Aneeshparveda/NEXUS-32/docs/STATUS.md

# NEXUS-32 Status

**Last updated: 2026-11-13.**

## Board evidence (2026-11-13)

The full SoC ran on a Digilent Basys 3. The record is in
[`results/board_2026-11-13/MANIFEST.md`](../results/board_2026-11-13/MANIFEST.md).

- **Build:** LANES=8, 50 MHz (MMCM), Vivado 2024.2, part `xc7a35tcpg236-1`,
  from commit `e17d20b` (RTL identical to `2f87f96`). Bitstream SHA-256
  `47778f086f2dbdc5f28398d9971b84cd960760fddf56c5cefc4eb3de6ce6f43d`.
- **Routed timing met at 50 MHz:** WNS +0.468 ns, WHS +0.014 ns, 0 failing
  endpoints.
- **Critical path:** in the sequential engine, `tap_count_q_reg` to
  `result_o_reg`, 19.453 ns over 30 logic levels.
- **Implemented utilization:** 4695 LUT, 3614 FF, 68/90 DSP48E1
  (PAR 32, PIPE 32, SEQ 4), 13/50 BRAM tiles. DRC 0 errors; Methodology
  0 critical.
- **On the board:**
  - LD0 and LD2 on, LD3 off.
  - The UART printed `NEXUS32 RESULT: PASS` with SEQ / PAR / PIPE
    `cycles_total` 14352 / 5136 / 9232, identical to simulation.
  - 82 reports, all PASS, 0 FAIL. 61 are complete; the other 21 were
    truncated by the terminal window.
- **Die temperature:** 33.3 °C, measured with System Monitor (XADC).
- **Power:** 0.194 W, a vectorless Vivado estimate dominated by the MMCM
  (87% of dynamic power).
- **Software baseline (RTL simulation):** the same FIR in plain C on the
  PicoRV32 alone (no multiplier) takes 13,289,345 cycles at 8 taps. The
  accelerator is 926x (SEQ) to 2,587x (PAR) faster at 8 taps, and up to
  15,818x faster at 32 taps. See
  [`experiments/sw_baseline/README.md`](../experiments/sw_baseline/README.md).

This file is the single detailed status record the README status banner
points to. The CI badge at the top of the README is the live CI signal;
the runs listed below are point-in-time checks.

## Current HEAD

- Last reviewed against main at `07551d8` ("Merge pull request #10",
  pre-Vivado audit fixes). This update adds the first board evidence.

## CI status

- CI run #17 on `b24474b`: completed, conclusion **success**
  (verified 2026-11-10 from the GitHub Actions API):
  https://github.com/Aneeshparveda/NEXUS-32/actions/runs/42710687047
- CI run #12 on `c74f5e1`: completed, conclusion **success**
  (verified 2026-10-26 from the GitHub Actions API):
  https://github.com/Aneeshparveda/NEXUS-32/actions/runs/40233635198
- CI run #10 on `21d2db4`: completed, conclusion **success**
  (verified 2026-10-26 from the GitHub Actions API):
  https://github.com/Aneeshparveda/NEXUS-32/actions/runs/40227687445
- Earlier CI run #8 on `dabb71b` was the last verified run recorded in
  the previous README banner; it is superseded as the latest check by
  runs #10 and #12 above.
- CI on any commit pushed after this STATUS update is not yet verified
  and must be checked the same way before it is claimed.
- Passing CI is simulation and toolchain evidence only. It does not
  perform Vivado synthesis, timing closure, bitstream generation, board
  programming, or physical validation.

## What is claimed

- Simulation + CI verification of the PicoRV32 SoC with Sequential,
  Parallel, and Pipelined FIR accelerators under the frozen Q16.16
  contract in `docs/ACCELERATOR_CONTRACT_V1.md`.
- Functional block-processing cycle counts and verification closure as
  recorded in `docs/VERIFICATION_CLOSURE.md` and summarised in the README
  Results section (simulation only; see the caveat attached to that
  table — the integrated shell serializes to one outstanding operation,
  so those counts are not standalone architecture throughput or PPA).
- SoC START-to-verdict latency of 129 cycles at LANES=32 is a simulation
  figure only, not a board measurement and not `CYCLES_TOTAL`.
- Board demo firmware, simulation only: through PicoRV32, a 1024-sample block
  with `TAP_COUNT = LANES` matches the Python-golden checksum on all three
  engines at LANES 4/8/16/32, and the UART report is decoded independently by
  `tests/rtl/tb_nexus32_soc_demo.sv` (`scripts/run_soc_demo.sh all`).

## What is NOT claimed

- Timing closure at 100 MHz is not claimed. 100 MHz builds miss timing
  (routed WNS -7.980 ns at LANES=4 and -8.935 ns at LANES=8, from the
  scripted Vivado 2024.2 run). Only the 50 MHz board build is
  timing-clean.
- Only the LANES=8 board build is hardware-verified. LANES=4 at 50 MHz
  also met timing in Vivado (WNS +0.417 ns) but was not run on the board.
  LANES=16/32 are not claimed for the board: the core sweep shows the
  selector needs more than the 90 DSP48E1 slices.
- The 25 MHz MMCM option has not been built.
- Power and junction temperature are Vivado estimates. Board current was
  not measured.
- No demo video exists yet.
- The board wrapper default (LANES=8 in `rtl/top_basys3.sv`) and the
  integrated shell default (LANES=32) are source defaults, not fit or
  timing results.

## Known limitations

- Vivado findings on the 50 MHz board build (advisory; RTL frozen for the
  board run; see `results/board_2026-11-13/MANIFEST.md`):
  - DSP48E1 inputs and outputs are not registered (DPIP-1, DPOP-1), which
    gives the 30-level sequential-engine path.
  - BRAM control pins are driven by a register with an asynchronous reset
    (REQP-1839).
  - A LUT drives the reset synchronizer's asynchronous preset (LUTAR-1).
  - The unused 7-segment display lights because its pins are not driven.
- `ARCH_SEL=11` is rejected; no adaptive/Auto policy is implemented.
  (`docs/ACCELERATOR_CONTRACT_V1.md`; `rtl/fir_arch_selector.sv`)
- The CPU integration is single-master and does not yet implement DMA,
  UART receive, GPIO, interrupts, Sample B, STREAM-DB, or the planned system
  debug monitor. The system page provides UART transmit and SYS_INFO only.
  (`rtl/fir_seq_accel.sv`, `rtl/nexus32_soc.sv`)
- PicoRV32 native memory has no dedicated error response input; the
  wrapper exposes sticky bus-fault status and passes the accelerator's
  diagnostic response data (for example the protected-memory sentinel
  `0xBAD0_0001`) through to the CPU on an errored MMIO response.
  (`rtl/nexus32_accel_bus.sv`; `rtl/nexus32_soc.sv`; `make test-fault`;
  assumed: the pinned `picorv32.v` was not checked)
- `LANES` also caps the filter length: `TAP_COUNT` must be 1..`LANES`, so a
  LANES=4 build runs at most a 4-tap filter. A larger `TAP_COUNT` is
  rejected at START as an invalid configuration.
  (`rtl/fir_seq_accel.sv` `config_valid`; `rtl/fir_arch_selector.sv`
  `invalid_request`)
- The block controller waits for each BRAM read response with no timeout
  (`EXEC_COEFF_WAIT`, `EXEC_SAMPLE_WAIT` in `rtl/fir_seq_accel.sv`). This
  relies on `rtl/fir_tap_bram.sv` answering every accepted read one cycle
  later. A lost response would leave `BUSY` set until `CTRL.RESET`; no test
  injects one, and the shipped BRAM cannot produce one.
- The parallel engine reports an invalid tap count as an `error_o` pulse
  with no `out_valid_o`, as its header and `docs/PARALLEL_ENGINE.md`
  state. Through `rtl/fir_arch_selector.sv` this is unreachable, because
  the selector answers invalid requests itself; a standalone user must
  watch `error_o`.
