Aneeshparveda/NEXUS-32/results/board_2026-11-13/screenshots.pdf

Evidence index (snapshot 2026-11-13, about 4:20 PM, final compile) | NEXUS-32 | LANES=8, 50 MHz | Vivado 2024.2 | page 1
# | Screenshot | State

1 | Sources hierarchy | In this PDF
2 | Top-level RTL schematic | In this PDF
3 | RTL schematic inside u_soc | In this PDF
4 | Synthesized utilization | In this PDF
5 | Routed timing summary | In this PDF
6 | Critical path | In this PDF
7 | Implemented utilization, Summary | In this PDF
8 | Implemented utilization, Hierarchy | In this PDF
DRC | DRC report (0 errors) | In this PDF
Meth | Methodology report (0 critical) | In this PDF
9 | Power estimate | In this PDF
9b | Power supply breakdown (Vccint 0.026 A) | In this PDF
10 | Device view, per-engine colours | In this PDF
10b | Colour legend | In this PDF
BS | Bitstream generated (Design Runs) | In this PDF
HW | Hardware Manager: board connected | In this PDF
11 | System Monitor temperature, 33.3 C (measured) | In this PDF
12 | UART report, NEXUS32 RESULT: PASS | In this PDF
S2 | Simulation waveform | In this PDF
Board | LED photo and board photos | In this PDF
S1 | Simulation console (3 x check=PASS) | Not captured; optional, covered by board UART log (82 x PASS)

Headline results (LANES=8, 50 MHz, xc7a35tcpg236-1)
Simulation PASS (cycles SEQ 14352 / PAR 5136 / PIPE 9232, checksum 0xb2be7f16). Synthesis, implementation and bitstream complete. Routed timing met: WNS +0.468 ns, WHS +0.014 ns, 0 failing endpoints. Implemented: 4695 LUT / 3614 FF / 68 DSP / 13 BRAM. Power estimate 0.194 W (MMCM 87% of dynamic); 163 DRC and 82 methodology warnings, no errors or critical items. On the Basys 3: LD0 and LD2 on, LD3 off, UART report NEXUS32 RESULT: PASS with cycles 14352 / 5136 / 9232 (identical to simulation), measured die temperature 33.3 C. Vivado power and junction temperature are estimates; the System Monitor reading is a measurement.

Screenshot 1: Sources hierarchy | NEXUS-32 | LANES=8, 50 MHz | Vivado 2024.2 | page 2

Hierarchy view: top_basys3 > u_soc (nexus32_soc) > u_uart_tx, u_cpu (picorv32), u_accel_bus > u_accel (fir_seq_accel) > u_tap_bram, u_arch_selector > u_seq_engine, u_parallel_engine, u_pipelined_engine. The xil_defaultlib.*_MUST_BE_* entries are parameter-guard modules for LANES and SYS_CLK_MHZ (valid at LANES=8, 50 MHz). Cropped from the Vivado window.

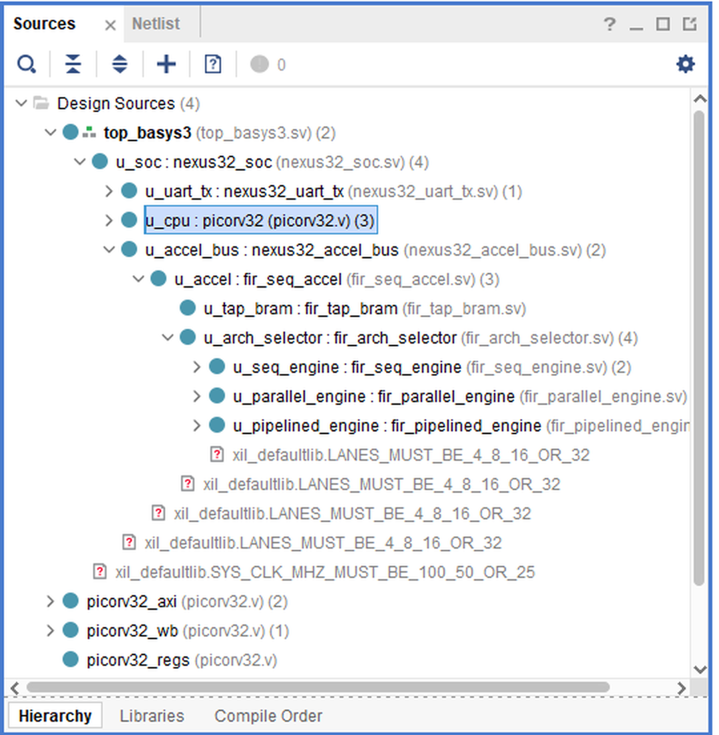
[picture p1: figure]

Screenshot 2: Top-level RTL schematic (elaborated design) | NEXUS-32 | LANES=8, 50 MHz | Vivado 2024.2 | page 3

10 cells, 7 I/O ports, 24 nets. Inputs clk_100mhz and btn_center; outputs led[3:0] and uart_tx. Shows the MMCM (gen_clk_mmcm.u_mmcm), BUFG, reset synchroniser and the single u_soc (nexus32_soc) block.

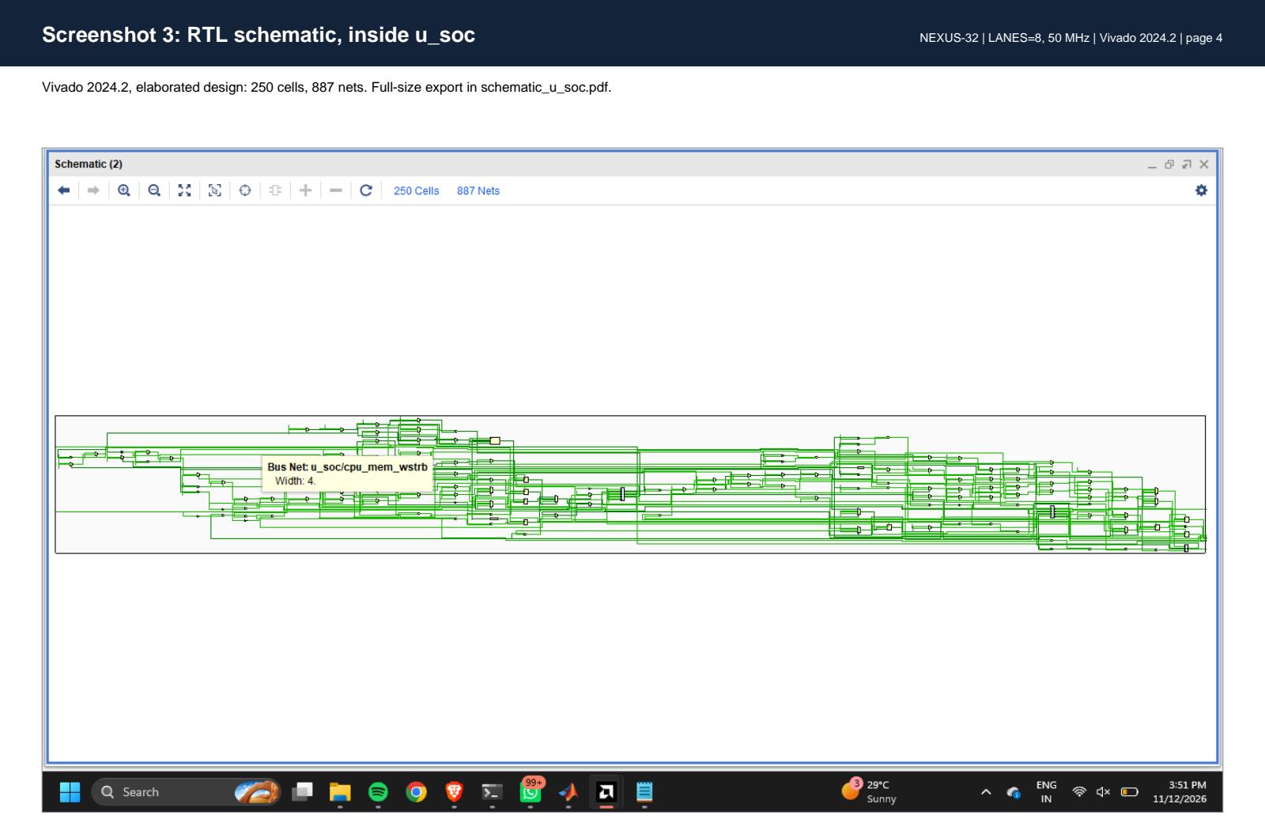
[picture p2: page 4]

Screenshot 3: RTL schematic, inside u_soc | NEXUS-32 | LANES=8, 50 MHz | Vivado 2024.2 | page 4

Vivado 2024.2, elaborated design: 250 cells, 887 nets. Full-size export in schematic_u_soc.pdf.

Screenshot 4: Synthesized utilization (LANES=8, 50 MHz) | NEXUS-32 | LANES=8, 50 MHz | Vivado 2024.2 | page 5

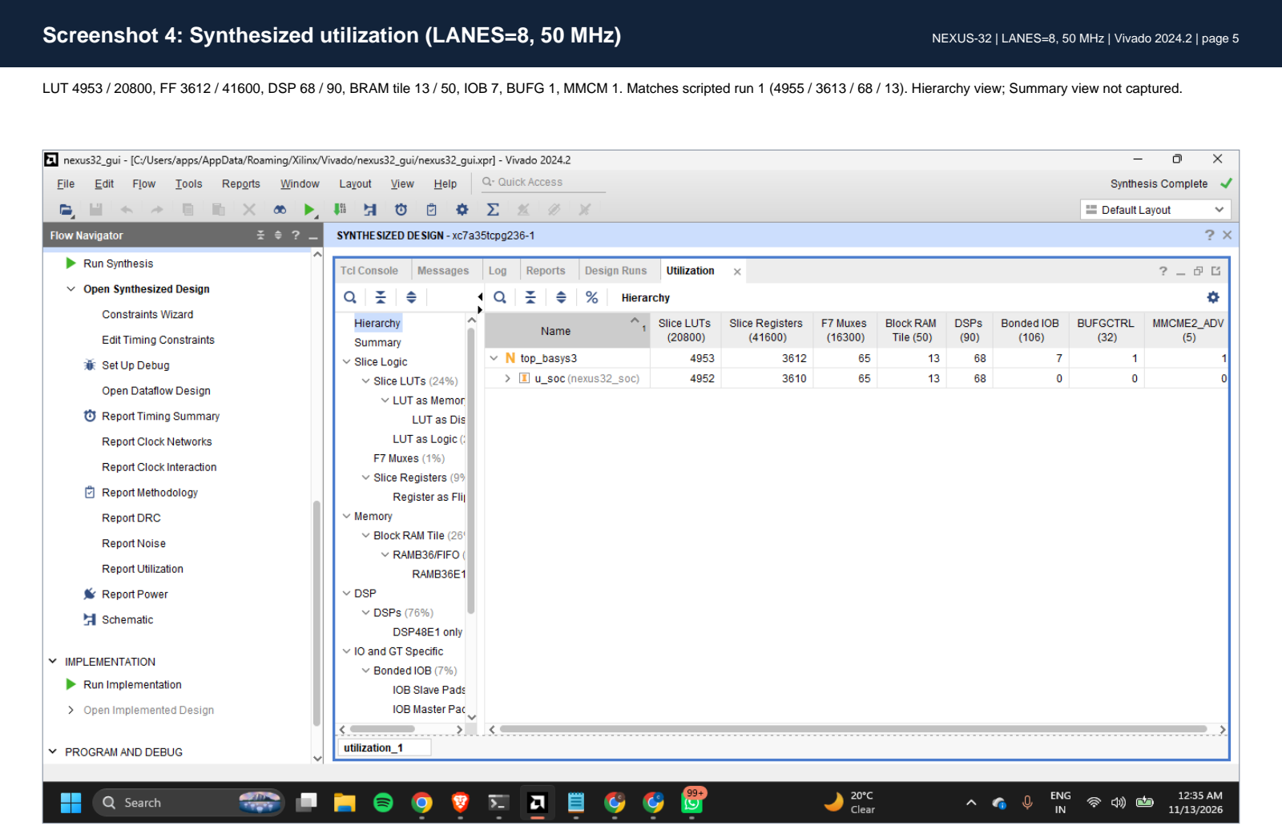
[picture p3: page 5]

LUT 4953 / 20800, FF 3612 / 41600, DSP 68 / 90, BRAM tile 13 / 50, IOB 7, BUFG 1, MMCM 1. Matches scripted run 1 (4955 / 3613 / 68 / 13). Hierarchy view; Summary view not captured.

Screenshot 5: Routed Design Timing Summary (50 MHz) | NEXUS-32 | LANES=8, 50 MHz | Vivado 2024.2 | page 6

WNS +0.468 ns, TNS 0, WHS +0.014 ns, THS 0, WPWS 3.000 ns. 0 failing endpoints. "All user specified timing constraints are met." Report: Timing Summary - impl_1 (saved), IMPLEMENTED DESIGN. Use WHS 0.014 ns; the scripted "WHS 3.000" is the pulse-width slack (script bug).

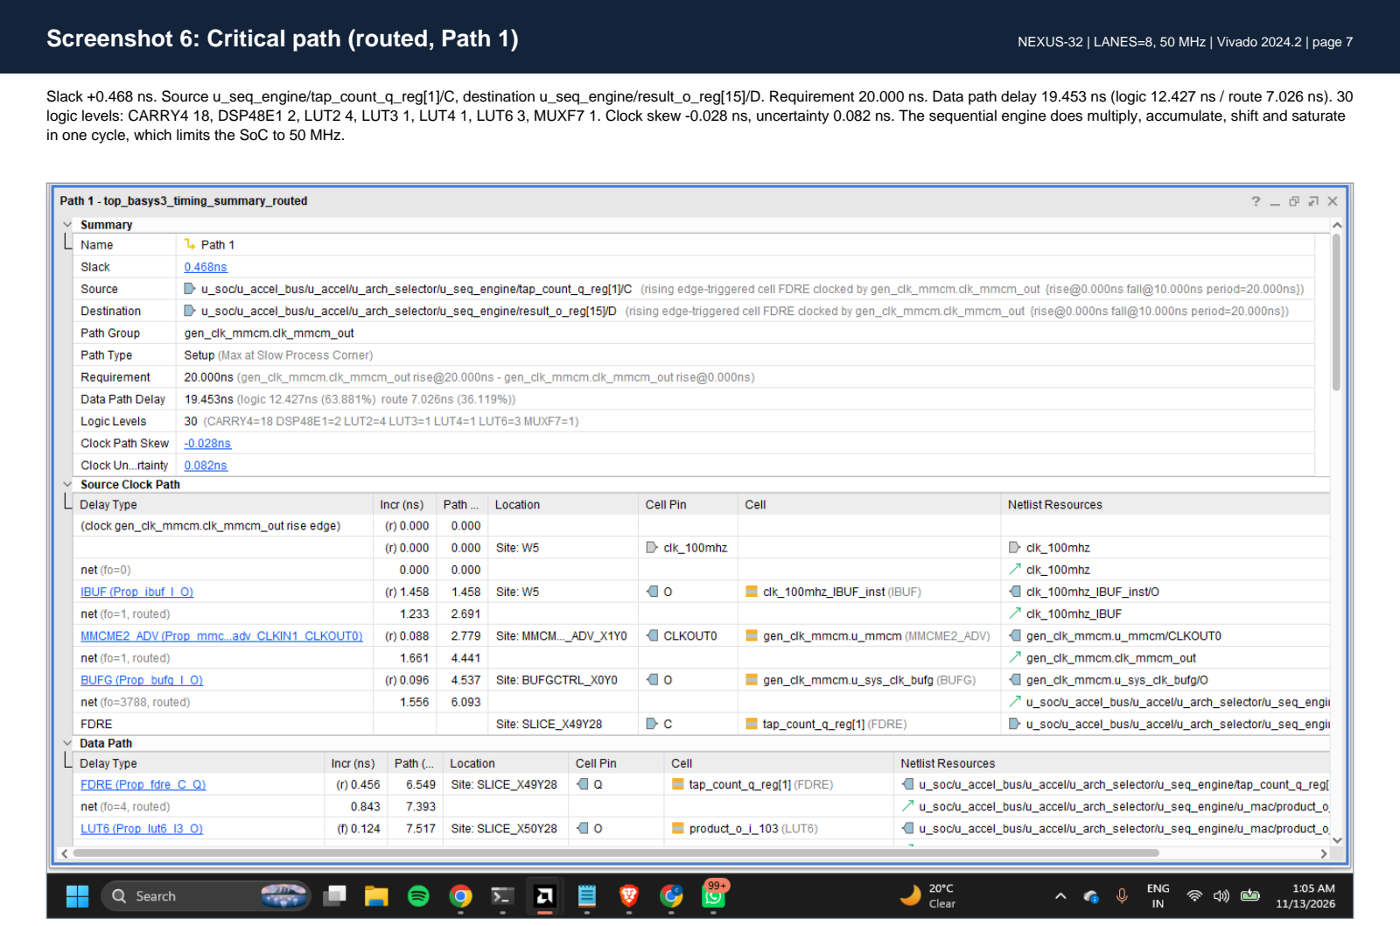
[picture p4: page 7]

Screenshot 6: Critical path (routed, Path 1) | NEXUS-32 | LANES=8, 50 MHz | Vivado 2024.2 | page 7

Slack +0.468 ns. Source u_seq_engine/tap_count_q_reg[1]/C, destination u_seq_engine/result_o_reg[15]/D. Requirement 20.000 ns. Data path delay 19.453 ns (logic 12.427 ns / route 7.026 ns). 30 logic levels: CARRY4 18, DSP48E1 2, LUT2 4, LUT3 1, LUT4 1, LUT6 3, MUXF7 1. Clock skew -0.028 ns, uncertainty 0.082 ns. The sequential engine does multiply, accumulate, shift and saturate in one cycle, which limits the SoC to 50 MHz.

Screenshot 7: Implemented utilization, Summary | NEXUS-32 | LANES=8, 50 MHz | Vivado 2024.2 | page 8

LUT 4695 (22.57%), LUTRAM 44, FF 3614 (8.69%), BRAM 13 (26.00%), DSP 68 (75.56%), IO 7, MMCM 1. BRAM, DSP, IO, MMCM identical to synthesis; LUT is 258 lower after optimization and placement. Nothing near 100%.

Screenshot 8: Implemented utilization, Hierarchy (engines expanded) | NEXUS-32 | LANES=8, 50 MHz | Vivado 2024.2 | page 9

u_arch_selector 2591 LUT / 68 DSP: parallel 1048 LUT / 32 DSP, pipelined 1182 LUT / 32 DSP, sequential 366 LUT / 4 DSP. u_tap_bram 579 LUT / 4 BRAM. u_cpu (picorv32) 968 LUT / 509 FF. u_uart_tx 23 LUT. DSP split 32 + 32 + 4 = 68.

Screenshot DRC: DRC report, routed design | NEXUS-32 | LANES=8, 50 MHz | Vivado 2024.2 | page 10

163 warnings, 0 errors, 0 critical. Visible: REQP-1839 rule limit reached (20 violations found), DSP48E1 pipelining advisories DPIP-1 (7 listed) and DPOP-1 (52 listed). Advisory only; the RTL is frozen. REQP-1839 is a known warning. Remaining entries not captured.

Screenshot Meth: Methodology report, routed design | NEXUS-32 | LANES=8, 50 MHz | Vivado 2024.2 | page 11

82 warnings, 0 critical. LUTAR-1 (1): LUT in front of the reset synchroniser async pin. SYNTH-6 (13): RAM blocks without a merged output register (dmem, imem, result_mem, coefficient_mem), timing may be sub-optimal. Remaining entries not captured. Advisory only.

Screenshot 9: Power summary (Vivado estimate, not a measurement) | NEXUS-32 | LANES=8, 50 MHz | Vivado 2024.2 | page 12

Total 0.194 W (dynamic 0.122 W, static 0.073 W); junction 26.0 C; thermal margin 59.0 C; confidence Medium. The MMCM is 87% of dynamic power (0.106 W), so power is dominated by clock generation. Vectorless estimate: do not use it to compare the engines.

Screenshot 9b: Power supply breakdown (Vivado estimate) | NEXUS-32 | LANES=8, 50 MHz | Vivado 2024.2 | page 13

Vccint 1.000 V: 0.026 A total (0.015 dynamic, 0.010 static). Vccaux 1.800 V: 0.071 A (0.059 dynamic; MMCM rail). Vccbram 0.001 A, Vccadc 0.020 A (static), Vcco33 0.001 A. All other rails 0. Estimates, not measurements.

Screenshot 10: Device view, placed and routed, per-engine colours | NEXUS-32 | LANES=8, 50 MHz | Vivado 2024.2 | page 14

Red = u_seq_engine (SEQ). Purple = u_parallel_engine (PAR). Yellow = u_pipelined_engine (PIPE). Blue = u_tap_bram. Green = u_cpu (picorv32). Teal outlines = uncoloured cells (UART, bus glue, top level). PAR and PIPE spread into narrow strips because each needs 32 DSP slices from the DSP columns.

Screenshot 10b: Colour legend for screenshot 10 (Netlist panel) | NEXUS-32 | LANES=8, 50 MHz | Vivado 2024.2 | page 15

Cropped from the Netlist window under IMPLEMENTED DESIGN. The coloured icons show the colour assigned to each block: u_parallel_engine purple, u_pipelined_engine yellow, u_seq_engine red, u_tap_bram blue, u_cpu green.

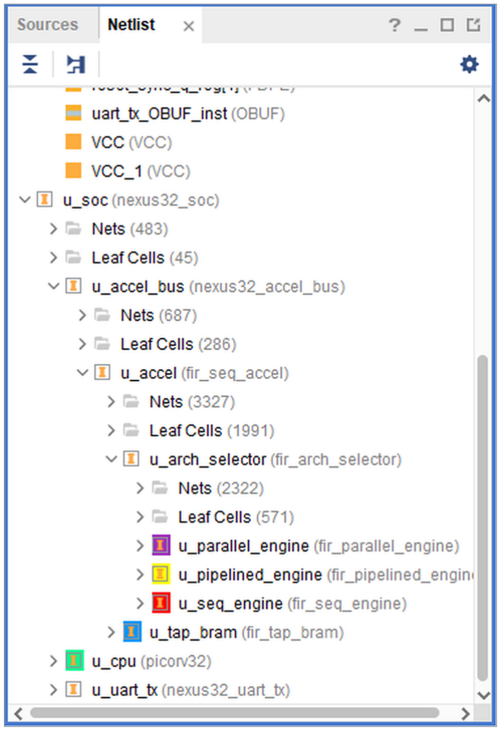
[picture p5: figure]

Screenshot BS: Bitstream generated (Design Runs) | NEXUS-32 | LANES=8, 50 MHz | Vivado 2024.2 | page 16

impl_1: write_bitstream Complete!, WNS 0.468, TNS 0.000, WHS 0.014, THS 0.000, total power 0.194 W, 0 failed routes, 82 methodology warnings. Generation started 1:28 AM; top_basys3.bit (about 2.08 MB) written 1:29 AM. Timing unchanged by bitstream generation.

Screenshot HW: Hardware Manager: Basys 3 connected | NEXUS-32 | LANES=8, 50 MHz | Vivado 2024.2 | page 17

hw_target xilinx_tcf/Digilent/210183B7AF46A open, xc7a35t_0 detected, "not programmed (DONE status = 0)" before programming. After Program Device the console reported "End of startup status: HIGH" and no supported debug cores (normal, none were added).

Screenshot 11: System Monitor (XADC) die temperature, measured on the board NEXUS-32 | LANES=8, 50 MHz | Vivado 2024.2 | page 18

Temp 33.3 C at 4:07 PM, chart range about 32 to 34.5 C over roughly one minute, xc7a35t_0 programmed with the LANES=8, 50 MHz bitstream. This is a measurement from the on-die sensor, unlike the 26.0 C Vivado estimate (which assumed 25 C ambient).

Screenshot 12: UART report from the Basys 3 (PuTTY, COM11, 115200 8N1) | NEXUS-32 | LANES=8, 50 MHz | Vivado 2024.2 | page 19

build: LANES=8 CLK_MHZ=50 TAP_COUNT=8 SAMPLE_COUNT=1024. SEQ / PAR / PIPE: check=PASS, cycles_total 14352 / 5136 / 9232, result_count 1024, checksum 0xb2be7f16 (golden), status 0x00000002. NEXUS32 RESULT: PASS. The report repeats (shown five times); the first copies wrap only because the window was narrower then. Identical to the simulation cycle counts.

Screenshot S2: Behavioral simulation waveform, LANES=8 | NEXUS-32 | LANES=8, 50 MHz | Vivado 2024.2 | page 20

Three accel_busy pulses (SEQ longest, PAR shortest). trap, cpu_bus_fault and accel_error stay 0. firmware_pass = 1, pass_checks = 3, fail_checks = 0, 0x20c (524) UART characters. Cycles SEQ 14352 / PAR 5136 / PIPE 9232.

Screenshot Board: Basys 3 programmed and running (LEDs) | NEXUS-32 | LANES=8, 50 MHz | Vivado 2024.2 | page 21

After programming top_basys3.bit: DONE (LD19) on, LD0 on, LD1 off, LD2 on, LD3 off, as expected. LD2 alone is not proof of a pass; the UART line (screenshot 12) is. The 7-segment display is not used by this design.

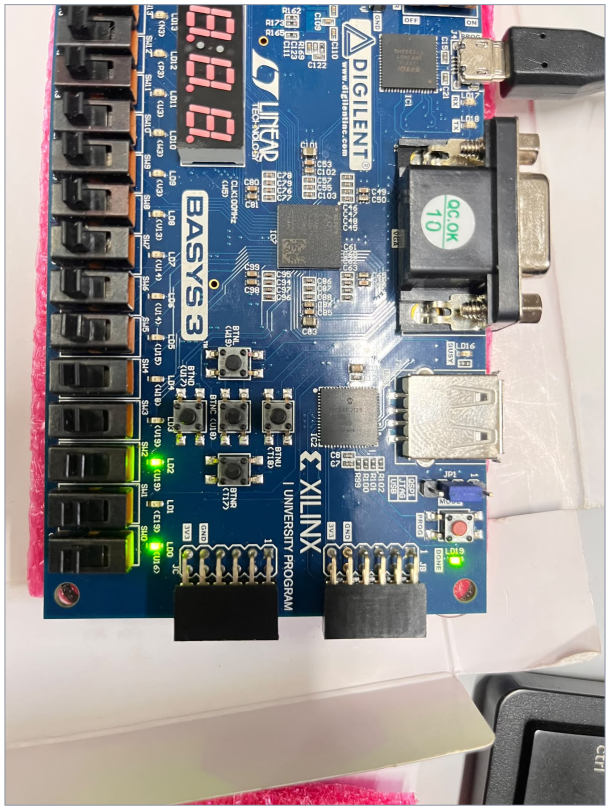
[picture p6: figure]

Screenshot Board: Board identification and setup | NEXUS-32 | LANES=8, 50 MHz | Vivado 2024.2 | page 22

Silkscreen reads BASYS 3 (Digilent, Xilinx University Program). Micro-USB in the PROG/UART port, red POWER LED on, enumerated as COM11. Photo taken before programming.

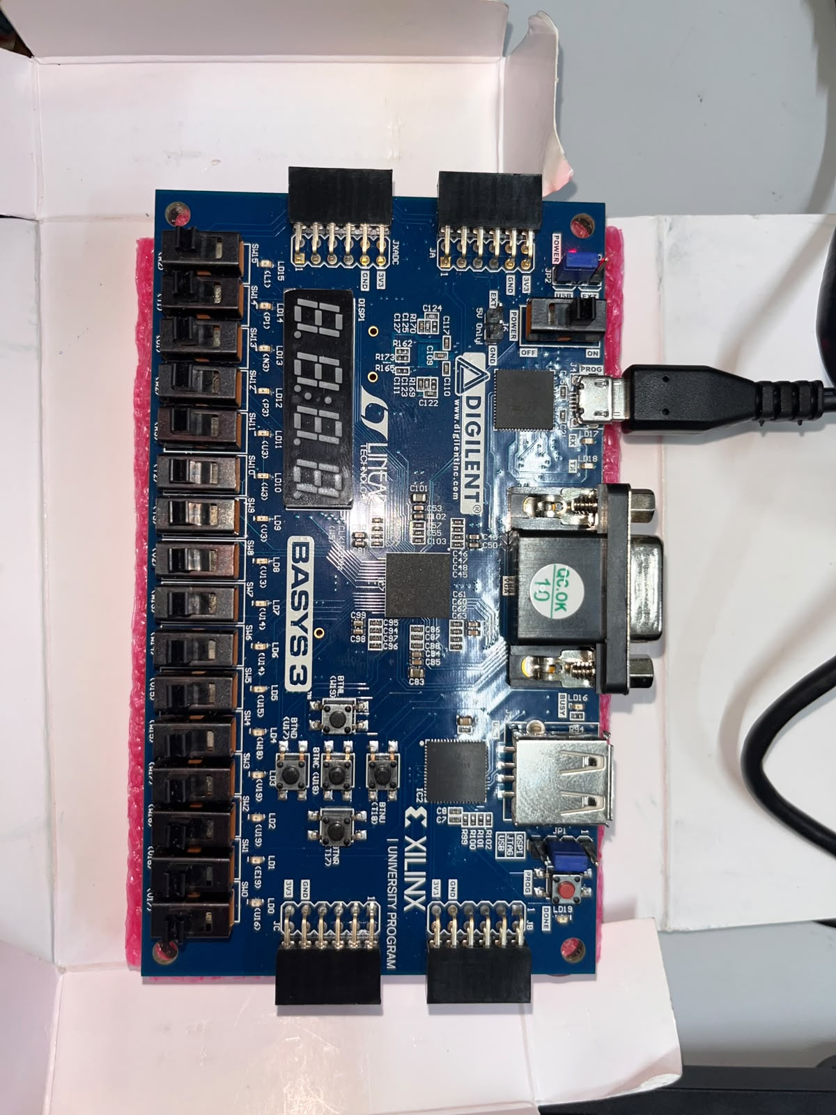
[picture p7: figure]
