Aneeshparveda/NEXUS-32/experiments/sw_baseline/result_l4.txt

SWFIR taps=4 cycles=6763452 checksum=0x8c4ef45f sig=0x600d600d trap=0 bus_fault=0 accel_busy_seen=0
