Aneeshparveda/NEXUS-32/experiments/sw_baseline/result_l8.txt

SWFIR taps=8 cycles=13289345 checksum=0xb2be7f16 sig=0x600d600d trap=0 bus_fault=0 accel_busy_seen=0
