Aneeshparveda/NEXUS-32/tests/rtl/tb_fir_seq_sync_source.sv

`timescale 1ns/1ps

// Models a synchronous dual-read tap source. The default mode returns each
// request one cycle later; the focused bubble case keeps accepting one request
// per cycle while returning ordered responses after deterministic multi-cycle
// delays. This verifies that the engine aligns returned data with its ordered
// request stream and waits for every valid response.
module tb_fir_seq_sync_source;
    logic clk_i = 1'b0;
    logic rst_i = 1'b1;
    logic start_i = 1'b0;
    logic [5:0] tap_count_i = 6'd0;
    logic tap_req_o;
    logic [4:0] tap_addr_o;
    logic read_valid_q = 1'b0;
    logic signed [31:0] sample_tap_q = 32'sd0;
    logic signed [31:0] coefficient_tap_q = 32'sd0;
    logic busy_o, done_o, error_o;
    logic signed [31:0] result_o;
    logic [15:0] cycles_o;

    logic signed [31:0] sample_mem [0:31];
    logic signed [31:0] coefficient_mem [0:31];
    integer issue_count = 0;
    logic bubble_response_mode = 1'b0;
    integer source_cycle = 0;
    integer source_request_count = 0;
    integer source_response_count = 0;
    integer response_consumed_count = 0;
    integer response_head = 0;
    integer response_tail = 0;
    integer response_due_cycle [0:31];
    logic signed [31:0] response_sample_q [0:31];
    logic signed [31:0] response_coefficient_q [0:31];

    always #5 clk_i = ~clk_i;

    function automatic integer bubble_response_delay(input integer request_index);
        begin
            // Requests continue every cycle, but selected responses are delayed
            // by several cycles. The resulting due cycles remain ordered and
            // contain deterministic bubbles between responses.
            case (request_index)
                0: bubble_response_delay = 2;
                1: bubble_response_delay = 4;
                2: bubble_response_delay = 7;
                default: bubble_response_delay = 9;
            endcase
        end
    endfunction

    always @(posedge clk_i) begin
        if (rst_i) begin
            read_valid_q <= 1'b0;
            sample_tap_q <= 32'sd0;
            coefficient_tap_q <= 32'sd0;
            source_cycle = 0;
            source_request_count = 0;
            source_response_count = 0;
            response_head = 0;
            response_tail = 0;
        end else begin
            source_cycle = source_cycle + 1;
            read_valid_q <= 1'b0;

            if (bubble_response_mode) begin
                if (tap_req_o) begin
                    if (response_tail >= 32)
                        $fatal(1, "response queue overflow");
                    response_sample_q[response_tail] = sample_mem[tap_addr_o];
                    response_coefficient_q[response_tail] = coefficient_mem[tap_addr_o];
                    response_due_cycle[response_tail] =
                        source_cycle + bubble_response_delay(source_request_count);
                    response_tail = response_tail + 1;
                    source_request_count = source_request_count + 1;
                end

                if ((response_head < response_tail) &&
                    (response_due_cycle[response_head] <= source_cycle)) begin
                    read_valid_q <= 1'b1;
                    sample_tap_q <= response_sample_q[response_head];
                    coefficient_tap_q <= response_coefficient_q[response_head];
                    source_response_count = source_response_count + 1;
                    response_head = response_head + 1;
                end
            end else begin
                read_valid_q <= tap_req_o;
                if (tap_req_o) begin
                    sample_tap_q <= sample_mem[tap_addr_o];
                    coefficient_tap_q <= coefficient_mem[tap_addr_o];
                end
            end
        end
    end

    // Independently check that each requested address is 0,1,...,tap_count-1.
    always @(posedge clk_i) begin
        if (rst_i) begin
            issue_count = 0;
        end else if (tap_req_o) begin
            if (tap_addr_o !== issue_count[4:0])
                $fatal(1, "request order mismatch: addr=%0d expected=%0d",
                       tap_addr_o, issue_count);
            issue_count = issue_count + 1;
        end
    end

    // The engine consumes a response on the same active edge on which the
    // source's registered valid signal is observed. This independent count is
    // used to prove that done_o cannot precede the final delayed response.
    always @(posedge clk_i) begin
        if (rst_i)
            response_consumed_count = 0;
        else if (bubble_response_mode && read_valid_q)
            response_consumed_count = response_consumed_count + 1;
    end

    fir_seq_engine dut (
        .clk_i(clk_i),
        .rst_i(rst_i),
        .start_i(start_i),
        .tap_count_i(tap_count_i),
        .tap_req_o(tap_req_o),
        .tap_addr_o(tap_addr_o),
        .tap_valid_i(read_valid_q),
        .sample_tap_i(sample_tap_q),
        .coefficient_tap_i(coefficient_tap_q),
        .busy_o(busy_o),
        .done_o(done_o),
        .error_o(error_o),
        .result_o(result_o),
        .cycles_o(cycles_o)
    );

    task automatic run_case(
        input logic [5:0] taps,
        input logic signed [31:0] expected_result,
        input logic [15:0] expected_cycles,
        input logic use_bubbles
    );
        integer guard;
        begin
            @(negedge clk_i);
            issue_count = 0;
            bubble_response_mode = use_bubbles;
            source_cycle = 0;
            source_request_count = 0;
            source_response_count = 0;
            response_consumed_count = 0;
            response_head = 0;
            response_tail = 0;
            tap_count_i = taps;
            start_i = 1'b1;
            @(negedge clk_i);
            start_i = 1'b0;

            guard = 0;
            while ((done_o !== 1'b1) && (error_o !== 1'b1) && (guard < 80)) begin
                @(negedge clk_i);
                guard = guard + 1;
            end

            if (error_o !== 1'b0)
                $fatal(1, "valid synchronous-source request rejected");
            if (done_o !== 1'b1)
                $fatal(1, "timeout waiting for synchronous-source result");
            if (result_o !== expected_result)
                $fatal(1, "sync-source result mismatch: got=%0d expected=%0d",
                       result_o, expected_result);
            if (cycles_o !== expected_cycles)
                $fatal(1, "sync-source cycle mismatch: got=%0d expected=%0d",
                       cycles_o, expected_cycles);
            if (issue_count != taps)
                $fatal(1, "issued %0d addresses, expected %0d", issue_count, taps);
            if (busy_o !== 1'b0)
                $fatal(1, "engine remained busy after synchronous-source result");
            if (use_bubbles) begin
                if (source_request_count != taps)
                    $fatal(1, "bubble source accepted %0d requests, expected %0d",
                           source_request_count, taps);
                if (source_response_count != taps || response_consumed_count != taps)
                    $fatal(1, "bubble response count mismatch: scheduled=%0d consumed=%0d expected=%0d",
                           source_response_count, response_consumed_count, taps);
                if (response_head != response_tail)
                    $fatal(1, "bubble source still has pending responses: head=%0d tail=%0d",
                           response_head, response_tail);
            end
            @(negedge clk_i);
            if (done_o !== 1'b0)
                $fatal(1, "done_o was not a one-cycle pulse");
            bubble_response_mode = 1'b0;
        end
    endtask

    integer i;
    initial begin
        for (i = 0; i < 32; i = i + 1) begin
            sample_mem[i] = 32'sd0;
            coefficient_mem[i] = 32'sd0;
        end

        // Four taps: 1*0.5 + (-1)*0.5 + 2*0.25 + 1*0 = 0.5.
        sample_mem[0] = 32'sd65536;
        coefficient_mem[0] = 32'sd32768;
        sample_mem[1] = -32'sd65536;
        coefficient_mem[1] = 32'sd32768;
        sample_mem[2] = 32'sd131072;
        coefficient_mem[2] = 32'sd16384;
        sample_mem[3] = 32'sd65536;
        coefficient_mem[3] = 32'sd0;

        repeat (2) @(negedge clk_i);
        rst_i = 1'b0;

        run_case(6'd4, 32'sd32768, 16'd5, 1'b0);

        // Delayed-response coverage: requests continue every cycle, while
        // responses for tap positions 0..3 arrive at deterministic later
        // cycles with several bubbles between them. Consecutive sample values
        // make response-order or duplicate-consumption errors observable.
        sample_mem[0] = 32'sd65536;
        sample_mem[1] = 32'sd131072;
        sample_mem[2] = 32'sd196608;
        sample_mem[3] = 32'sd262144;
        coefficient_mem[0] = 32'sd65536;
        coefficient_mem[1] = 32'sd131072;
        coefficient_mem[2] = 32'sd196608;
        coefficient_mem[3] = 32'sd262144;
        // (1*1 + 2*2 + 3*3 + 4*4) * 1.0 = 30.0 in Q16.16.
        run_case(6'd4, 32'sd1966080, 16'd14, 1'b1);

        // Repeat with a one-tap unity product; one source-latency cycle plus
        // one valid-response cycle gives two busy cycles.
        sample_mem[0] = 32'sd65536;
        coefficient_mem[0] = 32'sd65536;
        run_case(6'd1, 32'sd65536, 16'd2, 1'b0);

        $display("PASS: NEXUS-32 synchronous tap-source alignment tests");
        $finish;
    end
endmodule
