Aneeshparveda/NEXUS-32/tests/rtl/tb_fir_parallel_engine.sv

`timescale 1ns/1ps
module tb_fir_parallel_engine #(
    parameter int LANES = 32
);
    logic clk;
    logic rst;
    logic in_valid;
    logic in_ready;
    logic [5:0] tap_count;
    logic [LANES*32-1:0] sample_vector;
    logic [LANES*32-1:0] coefficient_vector;
    logic out_valid;
    logic out_ready;
    logic signed [31:0] out_result;
    logic error;
    logic [15:0] cycles;
    logic [LANES*32-1:0] s_work;
    logic [LANES*32-1:0] c_work;
    logic signed [31:0] expected_work;
    integer i;
    integer t;

    fir_parallel_engine #(.LANES(LANES)) dut (
        .clk_i(clk), .rst_i(rst),
        .in_valid_i(in_valid), .in_ready_o(in_ready),
        .tap_count_i(tap_count),
        .sample_vector_i(sample_vector),
        .coefficient_vector_i(coefficient_vector),
        .out_valid_o(out_valid), .out_ready_i(out_ready),
        .out_result_o(out_result), .error_o(error), .cycles_o(cycles)
    );

    always #5 clk = ~clk;

    function automatic logic signed [31:0] reference_result(
        input logic [5:0] n,
        input logic [LANES*32-1:0] samples,
        input logic [LANES*32-1:0] coefficients
    );
        logic signed [31:0] s;
        logic signed [31:0] c;
        logic signed [63:0] p;
        logic signed [71:0] acc;
        logic signed [71:0] shifted;
        integer k;
        begin
            acc = 72'sd0;
            for (k = 0; k < LANES; k = k + 1) begin
                if (k < n) begin
                    s = $signed(samples[k*32 +: 32]);
                    c = $signed(coefficients[k*32 +: 32]);
                    p = s * c;
                    acc = acc + $signed({{8{p[63]}}, p});
                end
            end
            shifted = acc >>> 16;
            if (shifted > 72'sd2147483647)
                reference_result = 32'sh7fffffff;
            else if (shifted < -72'sd2147483648)
                reference_result = 32'sh80000000;
            else
                reference_result = shifted[31:0];
        end
    endfunction

    task automatic send_good(
        input logic [5:0] n,
        input logic [LANES*32-1:0] samples,
        input logic [LANES*32-1:0] coefficients
    );
        logic signed [31:0] exp_result;
        begin
            exp_result = reference_result(n, samples, coefficients);
            @(negedge clk);
            while (!in_ready) @(negedge clk);
            in_valid = 1'b1;
            tap_count = n;
            sample_vector = samples;
            coefficient_vector = coefficients;
            @(posedge clk); #1;
            if (!out_valid) $fatal(1, "missing out_valid for tap_count=%0d", n);
            if (error) $fatal(1, "unexpected error for tap_count=%0d", n);
            if (out_result !== exp_result)
                $fatal(1, "parallel mismatch n=%0d got=%0d expected=%0d", n, out_result, exp_result);
            if (cycles !== 16'd1)
                $fatal(1, "expected one-cycle latency, got cycles=%0d", cycles);
            @(negedge clk);
            in_valid = 1'b0;
        end
    endtask
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
