Aneeshparveda/NEXUS-32/(commit log)

2026-10-15 Fix pipelined FIR tap-count width warning
    [fir_pipelined_engine.sv]
2026-10-17 fix: preserve latest accelerator debug event
    [fir_seq_accel.sv, tb_fir_seq_accel.sv, tb_nexus32_accel_bus.sv]
2026-10-18 fix: cancel result write on accepted accelerator reset
    [nexus32_accel_bus.sv]
2026-10-18 fix: align controller with physical commit guard
    [fir_seq_accel.sv, tb_fir_seq_accel_block_processing.sv]
2026-10-18 test: observe reset-edge physical writes
    [tb_fir_seq_accel_block_1024.sv]
2026-10-24 test: extend fixed-point boundary coverage
    [tb_fir_q16_primitives.sv]
2026-10-24 test: add firmware diagnostics and SoC error-path coverage
    [tb_nexus32_soc_invalid_arch.sv, tb_nexus32_soc_invalid_tap.sv, tb_nexus32_soc_latency.sv, tb_nexus32_soc_protected_access.sv, tb_nexus32_soc_timeout.sv]
2026-10-24 flow: harden Vivado provenance and report checks
2026-10-24 ci: wire the complete local and hosted verification gate
2026-10-24 M1: CI and documentation integrity + verification gaps (Waves A/B/C, Phase 6/6b)
    - CI fault-data wiring (closure gate -> make test-fault -> upload) and additive make test-all
    - Golden, sub-word, block-1024, and representative LANES=32 protected-access runners, plus selector/parallel/pipelined smoke wiring
    - CITATION, CONTRIBUTING, SECURITY, and docs index; contract section 11 evidence levels and verification closure addenda
    - Pre-release vendor/flow hardening and comment-only pipelined clarification
    - Carried open, not closed: toolchain pinning, Vivado 2024.2 fail-closed policy, ACT-08 dropped, C6 deferred
    - Protected-access remains representative LANES=32 only, not a full sweep
    - Vivado syn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
    [fir_pipelined_engine.sv, tb_nexus32_soc_block_1024.sv, tb_nexus32_soc_subword.sv]
2026-10-25 Verification: lab fixes, full-1024 block check, and U-A stall tests
    - Lab docs corrections, verification-closure enforcement loop, and early simulator gate
    - T3-2 full-1024 result check against the Python golden model at all LANES, plus negative cases
    - U-A pipelined stall/error and selector stall/quiescence bench scenarios
    - No RTL functional change (pipelined engine change is a header comment only); no firmware, Makefile, or CI workflow change in this commit
    - Simulation-validated on Mac with Icarus 13.0: make test-all passed, verification closure 15/0/0, Python 34 tests OK
    - Vivado synthesis, timing, bitstream, and board validation remain unverified
    [fir_pipelined_engine.sv, tb_fir_arch_selector.sv, tb_fir_pipelined_engine.sv, tb_nexus32_soc_block_1024.sv]
2026-10-25 Docs: README front matter, architecture diagrams, simulation results
    Add CI/MIT/SystemVerilog badges, an honest status box, and a Contents list. Add an Architecture diagrams section (SoC block diagram, FIR comparison, verification workflow; Vivado/board boxes dashed NOT YET DONE). Add a Simulation results (only) section (Seq 9222, Par 5126, Pipe 8198/9222/10246/11270; 129-cycle LANES=32 simulation latency; serialized-shell caveat). Insertions only: no existing README section was changed or reordered. Vivado synthesis/timing/bitstream/board remain unverified; Mermaid render check is pending on the rendered GitHub README.
2026-10-25 Revamp README: blueprint hero, results chart, honest board status
2026-10-25 docs: simplify README header, move status to docs/STATUS.md, clarify results caveat
    removed external header/footer images, typing banner and emoji; LANES=4 as recommended first board run; STATUS.md rewritten with known limitations kept. No RTL, results or CSR/memory-map changes.
2026-11-09 vivado: Windows-ready Basys 3 flow, BRAM-inferable memories, LANES=8 board default
    Prepare the first real Vivado run on a Windows host:
    - build_basys3.tcl: NEXUS32_INPUTS=prebuilt mode (default on Windows) that
    verifies the bundled pinned PicoRV32 (revision + SHA-256) and the 4096-word
    firmware image without bash, git or a RISC-V toolchain; git-less commit
    provenance from BUNDLE_COMMIT.txt; certutil SHA-256 fallback; quoted
    IMEM_INIT_FILE string generic with a working-copy fallback and
    NEXUS32_IMEM_GENERIC=0 escape hatch; post-synthesis IMEM INIT_00 guard so
    an unloaded firmware image fails the flow instead of producing a dead
    bitstream; no POSIX env dependency.
    - nexus32_soc.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
    [nexus32_accel_bus.sv, nexus32_soc.sv, top_basys3.sv]
2026-11-09 vivado: harden first-run flow (portable engine trees, MMCM clock fallback, XDC and launcher fixes)
    Second pre-Vivado pass aimed at an error-free first Windows run:
    - fir_parallel_engine / fir_pipelined_engine: each reduction-tree level is
    now driven only from inside its own generate scope; other levels are only
    read through gen_tree[...] names. Removes writes into another generate
    block's array, whose synthesis support is tool-dependent. Arithmetic and
    timing unchanged (differential 78/79/79/78 cases, pipeline latency, closure).
    - top_basys3: SYS_CLK_MHZ parameter (100 default = unchanged direct clock;
    50/25 = MMCME2_BASE, VCO 1000 MHz, + BUFG, reset held until LOCKED) as the
    fa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
    [basys3.xdc, fir_parallel_engine.sv, fir_pipelined_engine.sv, top_basys3.sv]
2026-11-09 feat: self-reporting UART board demo and one-click Windows Vivado evidence flow
    Board output that proves itself, and a Vivado day reduced to a few clicks.
    RTL
    - nexus32_uart_tx.sv: transmit-only 8N1 UART (exact CLKS_PER_BIT bit timing).
    - nexus32_soc.sv: local system page at 0x1000_6000 answered by the CPU
    bridge: UART_TXDATA, UART_STATUS (TX_READY, sticky TX_OVERRUN), SYS_INFO
    (0x4E58, CLK_MHZ, LANES); malformed accesses set the sticky bus fault.
    CLK_MHZ / UART_CLKS_PER_BIT parameters. PicoRV32 IRQ controller, IRQ timer
    and 64-bit counters disabled (unused; area). Cycle behaviour unchanged
    (SoC latency still 129).
    - top_basys3.sv: uart_tx port (A18, 115200 8N1); CLK_MHZ follows S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
2026-11-09 docs: futuristic README with animated system map and engine race
    - assets/nexus32-hero.svg: animated hero banner (glow title, circuit traces
    with moving signals, perspective grid, SIM VERIFIED / SILICON NEXT chips).
    - assets/nexus32-architecture.svg: circuit-map system diagram drawn from the
    RTL (CPU bridge, system page/UART, accel bus with ownership interlock,
    coefficient/sample/result RAMs, shell, selector, SEQ/PAR/PIPE, Q16.16 post,
    Basys 3 I/O) with packets animated along the real data paths.
    - assets/nexus32-engine-race.svg: CYCLES_TOTAL race from the LANES=8 demo
    simulation (PAR 5136, PIPE 9232, SEQ 14352); bars grow at one shared speed,
    labelled SIMULATION with the seriali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
2026-11-10 ci: gate golden, CPU block-1024, subword and lint; correct status docs
    Audit follow-up (2026-11-10). No file under rtl/, vivado/, constraints/ or
    firmware/ changes, so the Vivado handoff inputs are identical to b24474b.
    - make test-all and CI now run the golden regression, the CPU-driven
    1024-sample block (all LANES plus neg-n1..n4b) and the subword
    regression, through new targets golden, soc-block-1024 and subword.
    - Verilator lint is gated: scripts/check_lint_baseline.py fails on any
    project-RTL warning outside scripts/lint_baseline.txt. CI calls
    make verilator instead of duplicating the command.
    - scripts/run_rtl_smoke.sh exits non-zero instead of printing SKIP when
    the pinned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
2026-11-13 fix(vivado): unblock board builds and core sweep found in first real run
    The first Vivado 2026.1 run stopped every board build after synthesis:
    report_timing has no -unconstrained option (Common 17-170), so every
    later stage was skipped and no bitstream was written. The unconstrained
    report now uses check_timing -verbose (same file name).
    RUN_VIVADO_CORES.bat no longer aborts when vivado -version exits
    nonzero (seen on 2025.2 and 2026.1); only the real run is checked.
    The build flow now writes a best-effort post-route power estimate
    (reports/post_implementation/power.rpt); a failure there is recorded
    as SKIPPED so it cannot block the bitstream. collect_evidence copies it.
    The flow stub no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
2026-11-13 fix(vivado): report real hold slack and core-sweep LUT counts
    report_timing_summary ran with -delay_type max, so the summary had no
    hold columns and the parser read WPWS (pulse-width slack) as WHS_NS;
    TIMING_MET never checked hold. Both summary calls now use min_max. The
    real routed hold slack of the 50 MHz board build is +0.014 ns (GUI
    timing summary), not the 3.000 ns the scripted metrics showed.
    Out-of-context utilization reports print "Slice LUTs*", which the core
    sweep's regex missed, so every core LUT count was N/A.
    The flow stub now rejects -delay_type max.
2026-11-13 evidence: first Basys 3 board run (LANES=8, 50 MHz, UART PASS)
    Adds results/board_2026-11-13/: the UART log from the board, the
    captioned Vivado screenshots, the run status and a manifest with the
    build provenance (commit e17d20b, Vivado 2024.2, generics) and the
    bitstream SHA-256 47778f08...6f43d.
    Routed timing met at 50 MHz (WNS +0.468 ns, WHS +0.014 ns); 4695 LUT,
    68/90 DSP, 13 BRAM. On the board: LD0/LD2 on, LD3 off; 82/82 UART
    reports NEXUS32 RESULT: PASS with SEQ/PAR/PIPE cycles 14352/5136/9232,
    identical to simulation; die 33.3 C measured.
    Run by Chakshu.
2026-11-13 docs: record board evidence in STATUS and README
    STATUS: new Board evidence section; "not claimed" list now reflects the
    real limits (no 100 MHz closure, only LANES=8 verified on board, power
    is an estimate) and the Vivado advisories (DPIP/DPOP, REQP-1839,
    LUTAR-1, unused 7-segment pins). README: ledger rows for Vivado and
    silicon move from PENDING to measured, a software-baseline row, and the
    timeline ticks the first Vivado run and first silicon.
2026-11-13 demo: offline live demo page for the expo
    Single-file HTML: Q16.16 signal lab, CPU-versus-engines race from the
    measured software baseline, and a Web Serial board reader with a replay
    of the 2026-11-13 board log. Every number is labelled as simulation,
    estimate or measured.
2026-11-13 demo: v2 "logic analyser" presentation page
    Full redesign: a fixed 1366x768 letterboxed stage, 9 clicker steps
    (title, signal lab, race with a us-to-ms zoom-out, poll, twist,
    timing-path cause, live board), fonts and GSAP inlined for offline use.
    Same filter core (12/12 random cases match golden_model), same UART
    parser, same measured data and labels as the expo page, which stays as
    the fallback.
2026-11-13 demo: drop v2, show the 13 Nov board result on the expo page
    Removes nexus32_live_demo_v2.html and its README section; the expo
    page is the only demo. The board panel now states the measured run:
    82/82 UART PASS, cycles equal to simulation, die 33.3 C (XADC).
